epccs/Punica/Hardware/Design/17187BRD,BOM.csv

LINE | REF | QTY | EPCCS TYP | EPCCS PN | MFG@PN | DESCRIPTION | NOTES | COST EA | LINE COST | BIN
 |  |  |  |  |  | Punica Board |  |  | TOTAL
 |  |  |  |  |  | 11/8/17 (17187^1) |  |  | =SUM(J5:J100)
1 |  | =1/3 | BOARD | OSHPARK |  | PCB 2 LAYER ENIG 3 COPY | () | 68.25 | =C50*I50 | PUNICA
