epccs/Punica/Hardware/Evaluation/readme.md

# Description

This shows the setup and method used for evaluation of Punica.

# Table of References

# Table Of Contents:

1. ^0 TBD

## ^0 TBD

Evaluations are to be determined
