epccs/Punica/Hardware/Documents/17187,Schematic.pdf

## DIGITAL INPUT/OUTPUT 2,3,4

DIGITAL INPUT/OUTPUT 9,10,11 | DIGITAL INPUT/OUTPUT 12,13,22

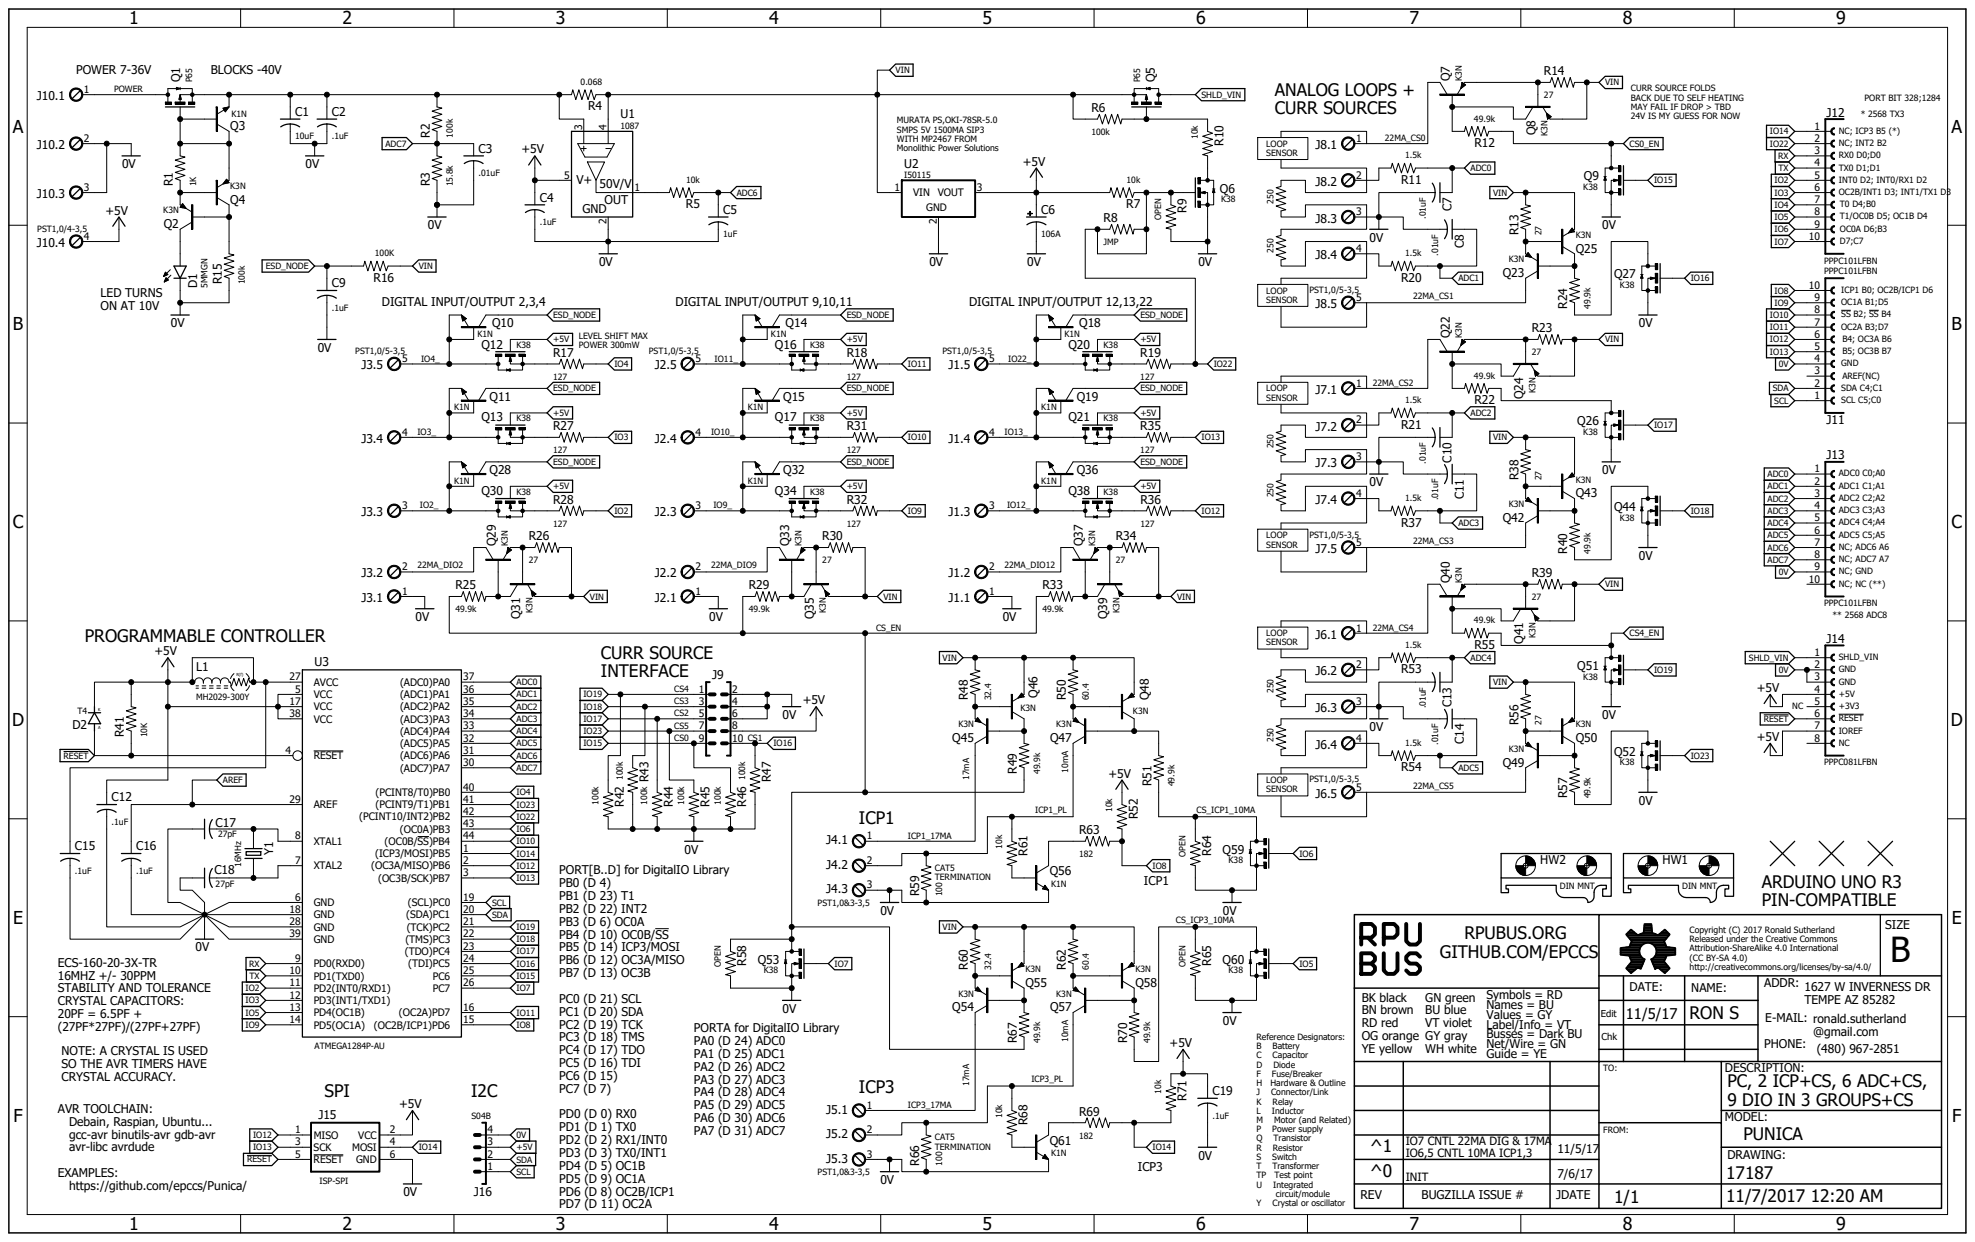
[picture p7: page 1]

VIN
CURR SOURCE FOLDS
BACK DUE TO SELF HEATING
MAY FAIL IF DROP > TBD
24V IS MY GUESS FOR NOW

Copyright (C) 2017 Ronald Sutherland
Released under the Creative Commons
Attribution-ShareAlike 4.0 International
http://creativecommons.org/licenses/by-sa/4.0/

ECS-160-20-3X-TR
16MHZ +/- 30PPM
STABILITY AND TOLERANCE
CRYSTAL CAPACITORS:
NOTE: A CRYSTAL IS USED
SO THE AVR TIMERS HAVE

Edit | 11/5/17 | RON S

Chk

AVR TOOLCHAIN:
Debain, Raspian, Ubuntu...
gcc-avr binutils-avr gdb-avr
avr-libc avrdude
EXAMPLES:
https://github.com/epccs/Punica/

^1 | IO7 CNTL 22MA DIG & 17MA IO6,5 CNTL 10MA ICP1,3 | 11/5/17
^0 | INIT | 7/6/17
REV | BUGZILLA ISSUE # | JDATE
