epccs/Punica/Hardware/Documents/17187,bAssy.pdf

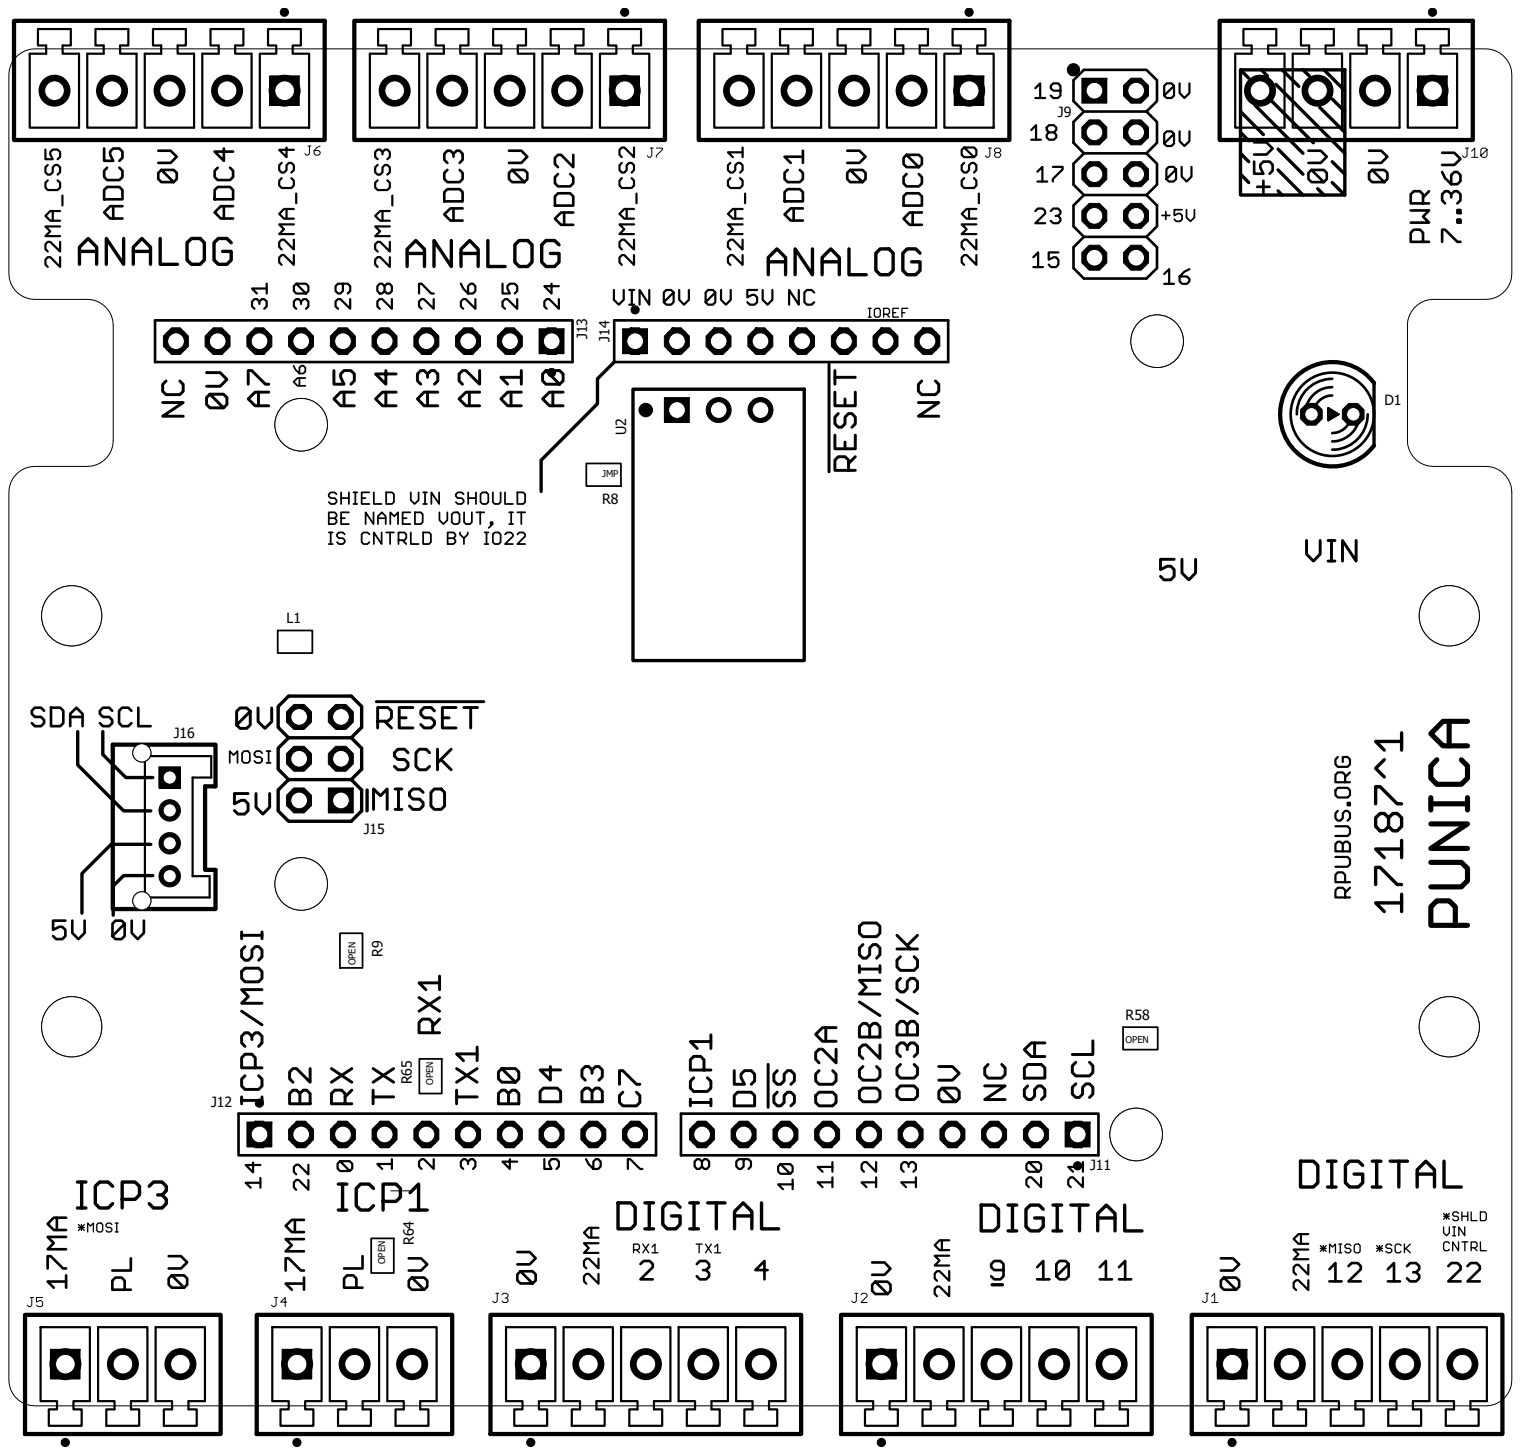
[picture p8: page 1]
