epccs/Punica/Hardware/Documents/17187,tAssy.pdf

C1

C2

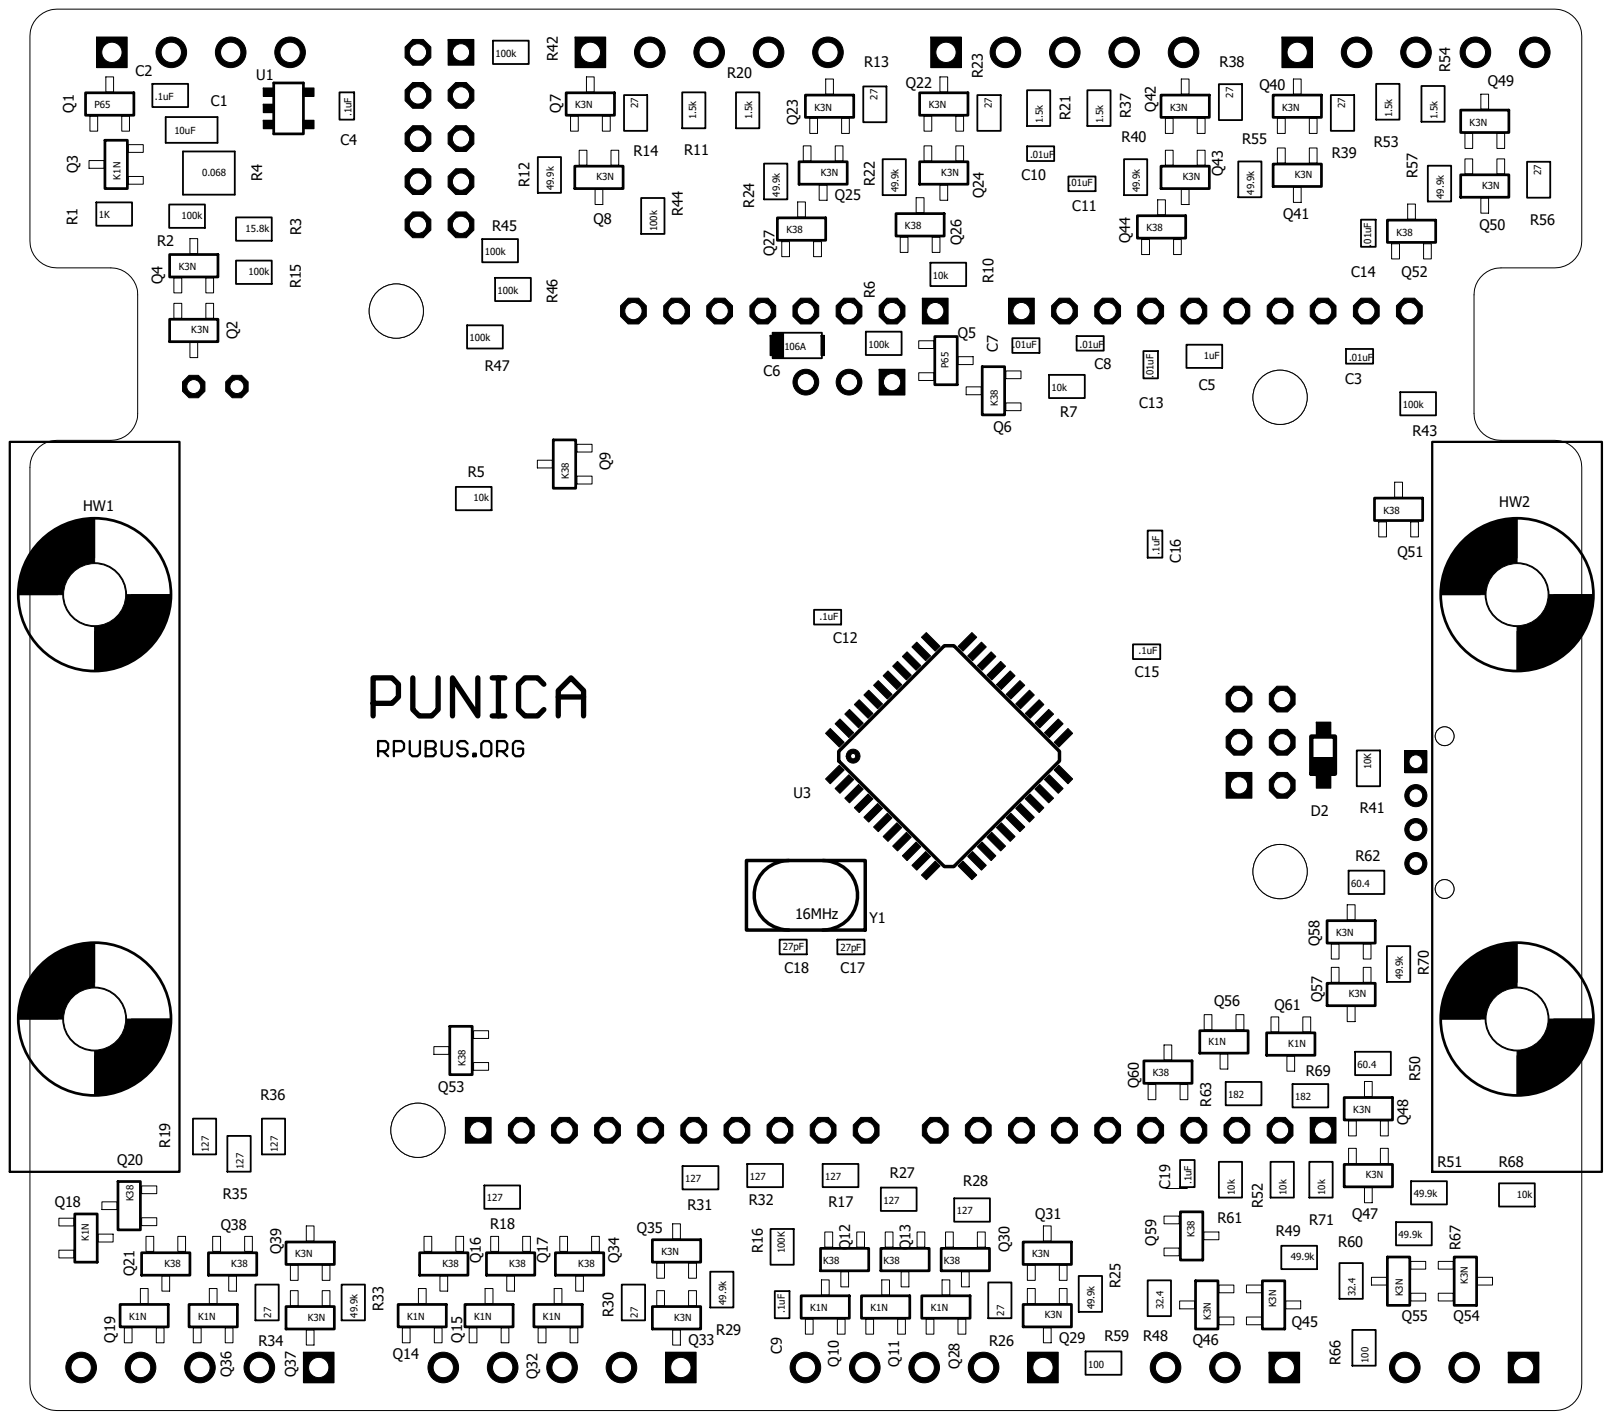
[picture p9: page 1]
