epccs/Punica/Hardware/Design/MultiDrop.sch

## EAGLE design Hardware/Design/MultiDrop.sch (2017-11-29)

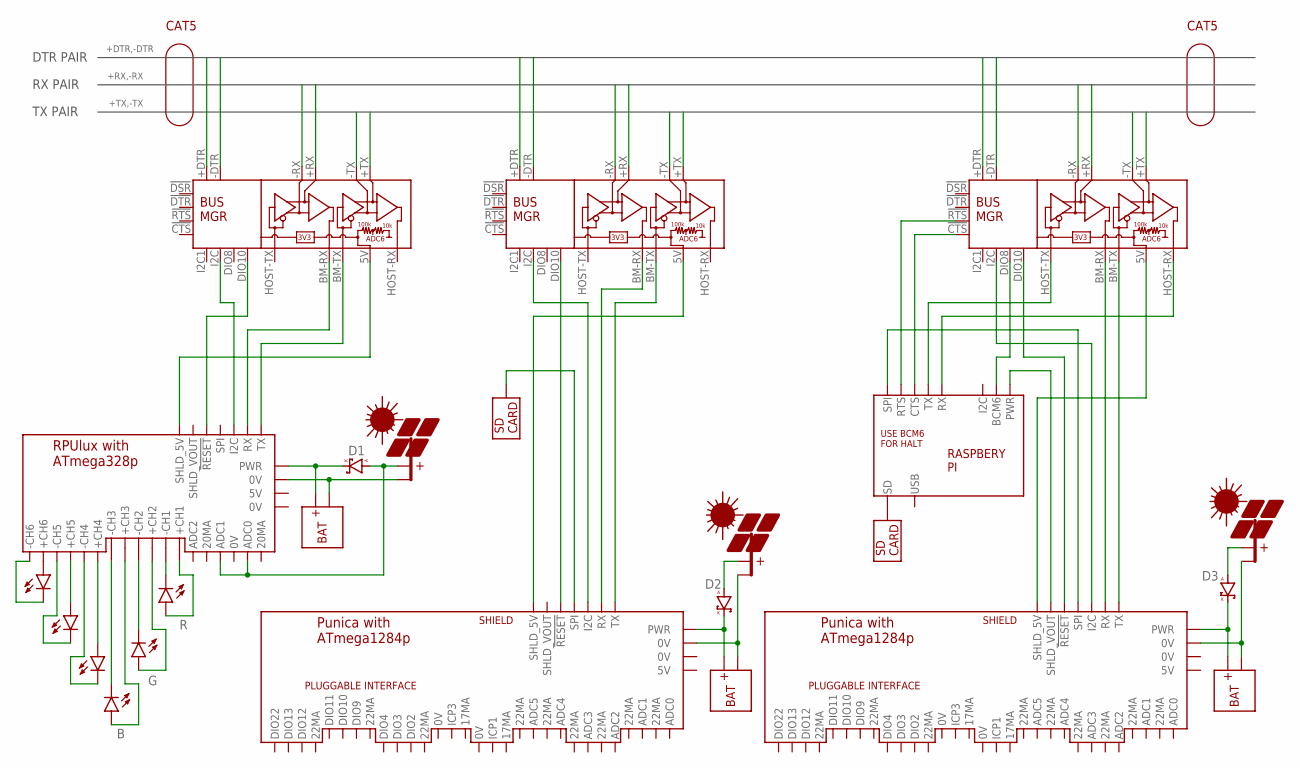
[picture p10: schematic MultiDrop.sch]

Parts:
B: LED5MM
BL2: LED5MM
D1, D2, D3: DSMB; SMB
G: LED5MM
GN2: LED5MM
PV1, PV2, PV4: PV; NA-30
R: LED5MM
RD2: LED5MM
SD1, SD2: SD; NA-30
U$1, U$2, U$4: BUS_MGR; WITH_RPU_NAMES
U$3: PI; NA-30
U$5, U$8: PUNICA; WITH_RPU_NAMES
U$6: RPULUX; WITH_RPU_NAMES
U$7, U$9, U$10: BAT; NA-30

Connections:
+DTR: U$4.+DTR
+DTR1: U$2.+DTR
+DTR3: U$1.+DTR
+RX: U$4.+RX
+RX1: U$2.+RX
+RX3: U$1.+RX
+TX: U$4.+TX
+TX1: U$2.+TX
+TX3: U$1.+TX
-DTR: U$4.-DTR
-DTR1: U$2.-DTR
-DTR3: U$1.-DTR
-RX: U$4.-RX
-RX1: U$2.-RX
-RX3: U$1.-RX
-TX: U$4.-TX
-TX1: U$2.-TX
-TX3: U$1.-TX
unnamed: U$4.BM-TX (BM_TX), U$6.TX
unnamed: U$4.BM-RX (BM_RX), U$6.RX
unnamed: D1.A, PV1.1 (+PV), U$6.ADC0, U$6.ADC1
unnamed: D1.K, U$6.PWR, U$10.1 (+BAT)
unnamed: R.K, U$6.-CH1
unnamed: R.A, U$6.+CH1
unnamed: G.A, U$6.+CH2
unnamed: G.K, U$6.-CH2
unnamed: B.A, U$6.+CH3
unnamed: U$2.BM-TX (BM_TX), U$5.TX
unnamed: U$2.BM-RX (BM_RX), U$5.RX
unnamed: U$1.DIO8, U$3.7 (BCM6)
unnamed: U$1.5V (PWR), U$8.SHLD_5V
unnamed: U$1.BM-TX (BM_TX), U$8.TX
unnamed: D3.K, U$7.1 (+BAT), U$8.PWR
unnamed: D3.A, PV4.1 (+PV)
unnamed: D2.A, PV2.1 (+PV)
unnamed: D2.K, U$5.PWR, U$9.1 (+BAT)
unnamed: SD1.1, U$5.SPI
unnamed: B.K, U$6.-CH3
unnamed: U$1.BM-RX (BM_RX), U$8.RX
unnamed: U$1.!CTS, U$3.1 (CTS)
unnamed: U$1.!RTS, U$3.2 (RTS)
unnamed: RD2.A, U$6.+CH4
unnamed: U$3.10 (SPI), U$8.SPI
unnamed: U$1.HOST-RX (HOST_RX), U$3.3 (RX)
unnamed: U$1.HOST-TX (HOST_TX), U$3.4 (TX)
unnamed: SD2.1, U$3.9 (SD)
unnamed: U$4.5V (PWR), U$6.SHLD_5V
unnamed: U$4.DIO10, U$6.!RESET
unnamed: RD2.K, U$6.-CH4
unnamed: U$1.I2C, U$8.I2C
unnamed: U$4.I2C, U$6.I2C
unnamed: BL2.A, U$6.+CH5
unnamed: BL2.K, U$6.-CH5
unnamed: GN2.A, U$6.+CH6
unnamed: GN2.K, U$6.-CH6
unnamed: PV1.2 (-PV), U$6.0V@PWR (0V), U$10.2 (-BAT)
unnamed: PV2.2 (-PV), U$5.0V@PWR (0V), U$9.2 (-BAT)
unnamed: U$3.12 (PWR), U$8.SHLD_VOUT
unnamed: PV4.2 (-PV), U$7.2 (-BAT), U$8.0V@PWR (0V)
unnamed: U$1.DIO10, U$8.!RESET
unnamed: U$2.DIO10, U$5.!RESET
unnamed: U$2.5V (PWR), U$5.SHLD_5V
unnamed: U$2.I2C, U$5.I2C

Notes on the sheet:
CAT5
DTR PAIR
RX PAIR
TX PAIR
