epccs/Punica/(commit log)

2017-09-27 Hardware: design rule checked
    [17187,BOM.csv]
2017-11-09 Hardware: ^1 has IO5..IO7 enable CS for digital and icp
    [17187,BOM.csv, 17187BRD,BOM.csv, 17187DIN,BOM.csv, 17187HDR,BOM.csv, 17187PLUG,BOM.csv, 17187SMD,BOM.csv]
2017-11-29 Hardware: add an example setup
    [MultiDrop.sch]
