epccs/Punica/(notices)

Notices in the files:
parts and their libraries:
Documentation: Copyright (C) 2014 Ronald Steven Sutherland
Attribution Share-Alike 3.0 License
http://creativecommons.org/licenses/by-sa/3.0
D-SBR: Copyright (C) 2013 Ronald Steven Sutherland
